shaheendibya/SAP-1-Architecture-based-8-bit-Computer-Design-and-Implementation-/(list of files, drawings)

Other design files:
4308_OEL_Silicon6-Final (2).pdsprj
Final_Project_Silicon6^-^ (2).pdsprj
